mechanart/mini-DVM/README.md

# mini-DVM
Tiny 30V Datalogger with Display
