mechanart/mini-DVM/Project Outputs for mini_DVM/BOM/Bill of Materials-mini-dvm.xls

Sheet: BOM Report
Bill of Materials |  |  | Bill of Materials For PCB Document [mini-dvm.PcbDoc]
Source Data From: |  | mini-dvm.PcbDoc
Project: |  | mini_DVM.PrjPcb
Variant: |  | None
Creation Date: | 1/27/2016 | 11:03:00 PM
Print Date: | 2016-01-27 | 23:03:23
Production Quantity: | 1
Currency | <none>
Footprint | #Column Name Error:Comment | #Column Name Error:LibRef | Designator | Description | Quantity | Supplier 1 | Supplier Part Number 1 | #Column Name Error:Supplier Unit Price 1 | #Column Name Error:Supplier Order Qty 1 | #Column Name Error:Supplier Subtotal 1 | #Column Name Error:Manufacturer 1 | #Column Name Error:Manufacturer Part Number 1
QFN50P300X300X100-17T180X180L |  |  | A1 | IC OPAMP 5V CMOS NANOPWR 16QFN | 1 | Digi-Key | 497-14091-1-ND
S2B-PH-SM4 |  |  | B1 | CONN HEADER PH SIDE 2POS 2MM SMD | 1 | Digi-Key | 455-1749-1-ND
CAPC1005X50L25N |  |  | C1, C2, C6, C10, C11 | CAP CER 10000PF 50V X7R 0402 | 5 | Digi-Key | 490-4516-1-ND
CAPC1005X50L25N |  |  | C3, C4, C5, C9, C19, C20, C22 | CAP CER 0.1UF 50V X7R 0402 | 7 | Digi-Key | 490-10700-1-ND
CAPC0603X33L15L |  |  | C7, C8 | CAP CER 15PF 25V NP0 0201 | 2 | Digi-Key | 490-10562-1-ND
CAPC1005X50L25N |  |  | C12, C13, C18, C21 | CAP CER 1UF 6.3V X7R 0402 | 4 | Digi-Key | 490-10024-1-ND
CAPC1220X95L30L |  |  | C14, C15, C16, C17 | CAP CER 10UF 6.3V X6S 0508 | 4 | Digi-Key | 587-3114-1-ND
SML-P11Mxxx |  |  | D1 | LED GREEN CLEAR 0402 SMD | 1 | Digi-Key | 511-1652-1-ND
HEADER_6_SMT_RA |  |  | J1 | CONN HEADER R/A 6POS GOLD SMD | 1 | Digi-Key | 3M9501CT-ND
microSD_ST11-H |  |  | J2 | CONN MICRO SD CARD PUSH-PUSH R/A | 1 | Digi-Key | 670-2695-1-ND
POGO_SPI |  |  | J3 | 5-pin SPI ISP pogo land with RST + GND | 1
HEADER_4_RA |  |  | J4, J5 | CONN HEADER 4POS R/A GOLD T/H | 2 | Digi-Key | A115235-ND
INDC3030X30L90L |  |  | L1 | FIXED IND 1.5UH 1.1A 49 MOHM SMD | 1 | Digi-Key | 490-9576-1-ND
RESC1508X50L30L |  |  | R5, R7, R9, R11 | RES SMD 9.09M OHM 1% 1/10W 0603 | 4 | Digi-Key | 541-9.09MHCT-ND
RESC1508X50L30L |  |  | R6, R8, R10, R12 | RES SMD 910K OHM 1% 1/10W 0603 | 4 | Digi-Key | 541-910KHCT-ND
RESC1005X40L25N |  |  | R13, R14, R15, R16, R18, R21, R22, R23 | RES SMD 10K OHM 5% 1/16W 0402 | 8 | Digi-Key | 541-10KJCT-ND
RESC1005X40L25N |  |  | R17 | RES SMD 680 OHM 1% 1/10W 0402 | 1 | Digi-Key | P680LCT-ND
RESC1005X40L25N |  |  | R19 | RES SMD 2.32K OHM 1% 1/10W 0402 | 1 | Digi-Key | P2.32KLCT-ND
RESC1005X40L25N |  |  | R20 | RES SMD 75K OHM 1% 1/10W 0402 | 1 | Digi-Key | P75.0KLCT-ND
TPwGND |  |  | TP5 |  | 1
X2QFN-10 |  |  | U1 | IC ADC 16-BIT I2C PROGBL 10-QFN | 1 | Digi-Key | 296-24935-1-ND
QFN50P500X500X100-33T325X325L |  |  | U2 | IC MCU 8BIT 32KB FLASH 32QFN | 1 | Digi-Key | ATMEGA328P-MURCT-ND
BGA6C40P3X2_157X88X50B23L |  |  | U3 | IC LI-ION CHARGE MGMT 6DSBGA | 1 | Digi-Key | 296-39933-1-ND
BGA12C40P4X3_168X128X62B25L |  |  | U4 | IC REG BCK BST 3.3V 0.5A 12DSBGA | 1 | Digi-Key | 296-40860-1-ND
PQFN50P400X400X60-25T290X290L |  |  | U5 | IC DRIVER 64LED MOBILE 24-TQFN | 1 | Digi-Key | AS1117-BQFTCT-ND
DIP762W51P254L1537H483Q12_SMT |  |  | U6, U7 | HP 4-Digit LED 7-Segment Bubble Display | 2 | Sparkfun | COM-12710
XTALDFN200X160X59-4L |  |  | Y1 | CRYSTAL 16.0000MHZ 10PF SMD | 1 | Digi-Key | 535-12628-1-ND
SON100P320X250X100-8L |  |  | Y2 | IC RTC CLK/CALENDAR I2C 8-SMT | 1 | Digi-Key | 535-11916-1-ND
 |  |  |  |  | 60 |  |  |  |  | $0.00
Approved |  | Notes

Sheet: Project Information
Project Full Path | C:\oshw\projects\mini-DVM\trunk\mini_DVM.PrjPcb
Project Filename | mini_DVM.PrjPcb
Variant Name | None
Data-Source Filename | mini-dvm.PcbDoc
Data-Source Full Path | C:\oshw\projects\mini-DVM\trunk\pcb\mini-dvm.PcbDoc
Title | Bill of Materials For PCB Document [mini-dvm.PcbDoc]
Total Quantity | 60
Report Time | 11:03:00 PM
Report Date | 1/27/2016
Report Date & Tine | 1/27/2016 11:03:00 PM
Output Name | Bill of Materials
Output Type | BOM_PartType
Output Generator Name | BOM
Output Generator Description | Bill of Materials
