mechanart/mini-DVM/(list of files, drawings)

Other design files:
mini_DVM.PrjPcb
pcb/mini-dvm.PcbDoc
sch/Analog_Front_End.SchDoc
sch/ATmega_MCU.SchDoc
sch/Battery_Power.SchDoc
sch/Display.SchDoc
sch/DVM_TopLevel.SchDoc
