mechanart/mini-DVM/(threads)

Thread 1 (2016-09-21):

ABM11 Incorrect Footprint

realpsyence, 2016-09-21:
Not 100% sure yet, but it definitely looks like the footprint is off for the ABM11 package - looks like I may have taken the bottom view instead of the top for pads.

realpsyence, 2016-12-14:
Fixed in commit 79d47fe80011d101b41d82c18c5a0b016c8a3b7b

Closed 2016-12-14.

Thread 2 (2016-09-22):

A1 J1 U1 Part Numbers Missing on Schematic

realpsyence, 2016-09-22:
1. A1 is a quad op-amp but no P/N is visible
2. J1 is an generic 100-mil spaced surface mount header wired as FTDI pinout: P/N is shown as "Manufacturer part number"
3. U1 is ADS1115 and P/N should be shown on schematic

Thread 3 (2016-09-22):

Schematic Sheets are not Numbered

realpsyence, 2016-09-22:
Causing an issue when printing - out of order and confusing printout.

Thread 10 (2016-12-14):

6-pin 0.1" Serial Header is too big

realpsyence, 2016-12-14:
It really is. It was used out of familiarity but dwarfs the system as a whole.

Replace with a micro-USB and put the USB-to-UART conversion on the board.

Possible solutions include the new X-series from FTDI, FT231X, FT230X, and FT234X all appear to satisfy our requirements, if DRT and RTS remain supported by the Arduino IDE:
https://forum.arduino.cc/index.php?topic=343182.0

Thread 4 (2016-12-14):

Tx Rx Swapped re: FTDI header

realpsyence, 2016-12-14:
The UART is wired incorrectly for use with a standard 6-pin 0.100" header and FTDI UART-to-USB cable.

Fix is to swap Tx/Rx from uC.

Thread 5 (2016-12-14):

AB-RTCMK-32 Module has Clock Out Disabled

realpsyence, 2016-12-14:
A testpoint was placed for CLKOUT but both CLKOUT and CLKOE (output enable) were tied to GND - forcing the output off and making the testpoint useless. Additionally, routing was too tight to reenable.

Fix by adding pull-up/pull down resistors to CLKOE and remove connection between CLKOUT and GND.

Optionally connect to micro.

Thread 6 (2016-12-14):

SPI should be brought out to a connector

realpsyence, 2016-12-14:
SPI is very useful for adding sensors. Bring SPI and a GPIO for chip select out to a connector or large testpoints.

One possibility would be to add a GPIO to the Atmel ISP pogo lands.

Thread 7 (2016-12-14):

I2C should be brought out to a connector.

realpsyence, 2016-12-14:
As with SPI; I2C support would be incredibly handy. Bring out SDA, SCL, GND, and possibly VDD to a connector.

One possibility would be to further extend the ISP lands to include SDA and SCL.

Thread 8 (2016-12-14):

ISP Pogo Lands are missing Silkscreen

realpsyence, 2016-12-14:
Labels should be added to these and any other testpoints missing labels.

Thread 9 (2016-12-14):

A1 cannot pull it's output closer than 40mV of the negative rail

realpsyence, 2016-12-14:
Leads to some funny behavior with low voltage inputs.

Might be livable. Can support voltages > 0.4V

Thread 11 (2017-02-24):

RTC should have backup battery

realpsyence, 2017-02-24:
Separate from main LiPo the RTC should have a small replaceable primary cell - perhaps as an option?

Thread 12 (2017-02-24):

100-mil header for UART is ungainly and should be replaced

realpsyence, 2017-02-24:
The external FTDI cable adds cost and inhibits quick start of the product. It is also very large relative to the rest of the project and makes designing a nice enclosure more difficult.

Solution:  bring FTDI chip on-board and replace header with micro-USB.

Invalidates issue #4
