mechanart/mini-DVM/(commit log)

2015-10-10 Initial check-in of DVM logger project.
    [Analog_Front_End.SchDoc, DVM_TopLevel.SchDoc, mini_DVM.PrjPcb]
2015-10-12 Updates - added ADS1115 and AD8603 to front-end.
    [Analog_Front_End.SchDoc, DVM_TopLevel.SchDoc, mini_DVM.PrjPcb]
2015-10-13 Rearranged to add pcb and sch folders. Initial commit of pcbdoc
    [ATmega_MCU.SchDoc, Analog_Front_End.SchDoc, DVM_TopLevel.SchDoc, mini-dvm.PcbDoc]
2015-10-13 Added Atmega328P
    [ATmega_MCU.SchDoc, Analog_Front_End.SchDoc, DVM_TopLevel.SchDoc, mini-dvm.PcbDoc, mini_DVM.PrjPcb]
2015-10-14 Added Display and Battery_Power schematic sheets.
    [Analog_Front_End.SchDoc, Battery_Power.SchDoc, DVM_TopLevel.SchDoc, Display.SchDoc]
2015-10-15 Updated 3D models for batt holder, major components.
    [ATmega_MCU.SchDoc, Analog_Front_End.SchDoc, Battery_Power.SchDoc, Display.SchDoc, mini-dvm.PcbDoc, mini_DVM.PrjPcb]
2015-10-17 Swapped coin cell for a JST-PH connector.
    [Battery_Power.SchDoc, mini-dvm.PcbDoc, mini_DVM.PrjPcb]
2015-10-17 Moved back to 1 in^2 square board outline due to Micro-SD constraints. Adding some datasheets to the docs/ folder. (AS1117 and Bubble Display QDSP-6064) Initial Check-in of PrjPcbStructure file.
    [mini-dvm.PcbDoc]
2015-10-30 Updates to footprints for resistors.
    [ATmega_MCU.SchDoc, Analog_Front_End.SchDoc, Battery_Power.SchDoc, Display.SchDoc, mini-dvm.PcbDoc, mini_DVM.PrjPcb]
2015-12-04 Started wiring up the displays, swapped op-amp for the TSU104 from ST Micro.
    [Analog_Front_End.SchDoc, Display.SchDoc]
2015-12-04 Dual bubble display wired up.
    [Display.SchDoc]
2015-12-04 MCU and TopLevel clean-up - front end has decoupled TSU104s.
    [ATmega_MCU.SchDoc, Analog_Front_End.SchDoc, DVM_TopLevel.SchDoc]
2015-12-06 Schematic updates: crystal for MCU almost in, minor other updates/cleanup.
    Adding datasheets for (new) TI battery charger bq2510x and TPS6305x buck-boost.
    [ATmega_MCU.SchDoc, Analog_Front_End.SchDoc, Battery_Power.SchDoc, DVM_TopLevel.SchDoc, Display.SchDoc, mini_DVM.PrjPcb]
2015-12-07 Updates - added SPI pogo lands for ISP programming. Placed all components on board for fit check. So far so good.
    [ATmega_MCU.SchDoc, Analog_Front_End.SchDoc, Display.SchDoc, mini-dvm.PcbDoc, mini_DVM.PrjPcb]
2015-12-07 component placement updates. MCU moved to same layer as switcher, display driver under top display near top edge of board, analog inputs along bottom edge. Op-Amp in corner with most analog routes ou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
    [mini-dvm.PcbDoc]
2015-12-09 Updatign DVM project - started to do component placement in preparation for routing. Fixed an issue with the quad op-amp symbol and updated all from libraries.
    [ATmega_MCU.SchDoc, Analog_Front_End.SchDoc, Battery_Power.SchDoc, Display.SchDoc, mini-dvm.PcbDoc, mini_DVM.PrjPcb]
2015-12-09 Placement updates.
    [mini-dvm.PcbDoc, mini_DVM.PrjPcb]
2015-12-11 Minor routing updates. Pulled in 3d-body for HEADER_6_SMT_RA
    [ATmega_MCU.SchDoc, mini-dvm.PcbDoc]
2015-12-14 more routing. getting complicated - should move to / stick with an orthogonal scheme.
    [Analog_Front_End.SchDoc, Battery_Power.SchDoc, DVM_TopLevel.SchDoc, mini-dvm.PcbDoc]
2015-12-18 Display is now routed.
    [mini-dvm.PcbDoc]
2015-12-20 More minor routing updates.
    [mini-dvm.PcbDoc]
2015-12-21 Routing updates. Needs cleanup. All but PWR/GND and Reset/Tx/Rx are routed.
    [mini-dvm.PcbDoc]
2016-01-01 Routing (silkscreen) cleanup - almost ready for test-run. Connected Display IRQ to MCU Added basic gerber + NC drill output job
    [ATmega_MCU.SchDoc, DVM_TopLevel.SchDoc, mini-dvm.PcbDoc, mini_DVM.PrjPcb]
2016-01-01 Minor routing updates. One more tweak and send it off!
    [mini-dvm.PcbDoc]
2016-04-18 Adding output job to Mini-DVM project. Updated layout. Added STEP model of layout as sent to OSHpark Adding outputs as fabbed.
    [Bill of Materials-mini-dvm.xls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]
2016-10-31 Corrected ABM11 footprint issue
    Updated in library and replaced schematic and footprint. Updated
    footprint routed and past DRC.
    [ATmega_MCU.SchDoc, mini-dvm.PcbDoc]
2016-11-04 fixed serial rx/tx issue
    Tx of MCU goes to Rx of FTDI
    [ATmega_MCU.SchDoc]
2016-11-04 updated pcb with Tx/Rx swap fixed
    Fixed routing of MCU Tx to FTDI Rx in PCB
    [mini-dvm.PcbDoc]
2017-03-05 Cleaned up FT234X schematic and removed 6-pin header.
    [ATmega_MCU.SchDoc]
